ra0sms/SWR_PWR_meter/(commit log)

2021-03-12 Add switching power 2000/1000/200W
2026-10-14 Add pre-built firmware, unify dark theme, improve reliability and security
    - Add ready firmware binaries (auth/noauth) for NodeMCU 0.9
    - Unify dark theme across /, /wifi and /swr pages
    - Restore blocking waitForConnectResult (fixes first-connect failure)
    - Add reconnect on connection loss, no-cache headers, SWR clamp
    - Add SSB/CW/FT8 smoothing mode selector (RAM only)
    - Add optional HTTP Basic Auth (AUTH_ENABLED flag)
    - Larger SSID/password buffers, input validation
    - Update README with firmware links and changelog
2026-10-15 Smooth PEP display for SSB/CW, chip-ID SoftAP name, reliability fixes
    Measurement:
    - Peak-hold sampling on the device: report the maximum over a 100-200 ms
    window instead of the last instantaneous sample
    - Forward/reflected measured in close pairs, SWR taken at the envelope peak
    - New /data JSON endpoint; /xml kept for external integrations
    - Wi-Fi modem sleep disabled (removes 100-300 ms random latency)
    Web interface:
    - Time-based ballistics (attack/hold/release) per SSB/CW/FT8 mode,
    rendering via requestAnimationFrame, peak marker on the bar
    - Sequential polling with timeout, stale-data indication
    - SWR holds last value during pauses, throttled/quantized numbers
    Other:
    - SoftAP SSID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
2026-10-16 Faster power display: quick drop to zero after TX, fast FT8 rise
    - Power reading falls to zero quickly when the carrier disappears
    (separate drop time constant + snap to 0) instead of an exponential
    tail that took several seconds; peak marker follows it to zero
    - Shorter hold/release in SSB (700 ms / 0.6 s) and CW (300 ms / 0.3 s)
    - FT8: attack 0.3 s -> 0.05 s, constant carrier reaches full reading fast
    - Rebuilt pre-built firmware, updated README
2026-10-16 Update user manuals (Russian and English)
    - Rewritten for the current firmware: unique SoftAP name SWRmeter_XXXXXX,
    optional authentication, step-by-step Wi-Fi setup, LED meaning
    - New sections: meter page (bar, peak marker, SWR hold, SSB/CW/FT8 modes),
    troubleshooting, RF interference and how to suppress it
    - Specifications aligned between languages; schematic page kept
